ViktorVaczi90/viztisztito_kicad/viztisztito-B_Cu.pdf

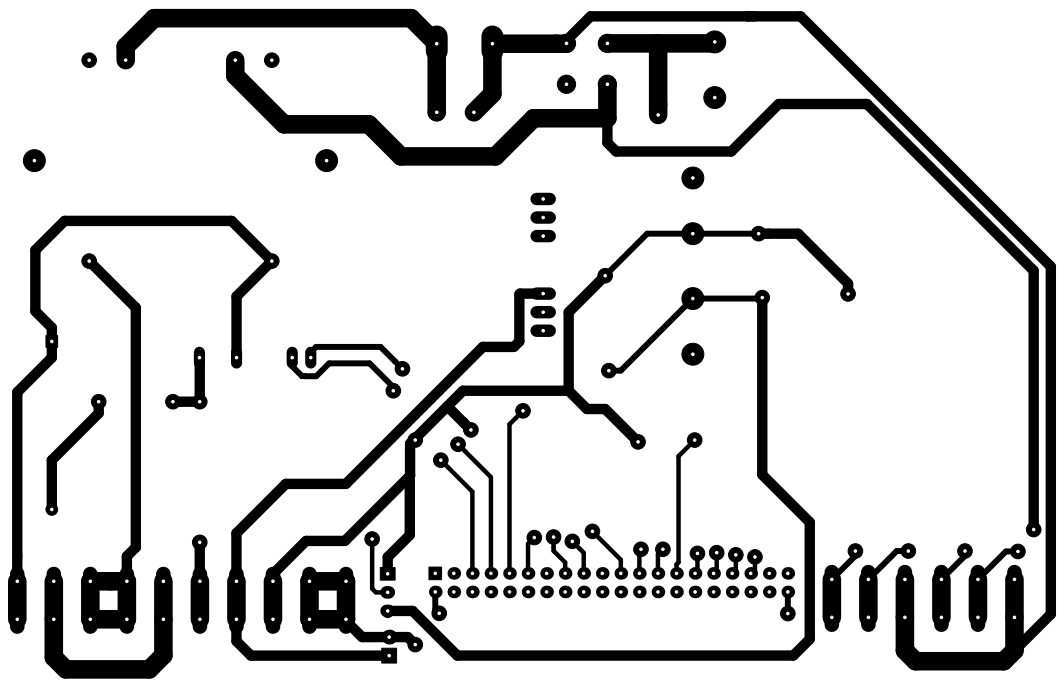
[picture p1: page 1]
