ViktorVaczi90/viztisztito_kicad/viztisztito-F_Cu.pdf

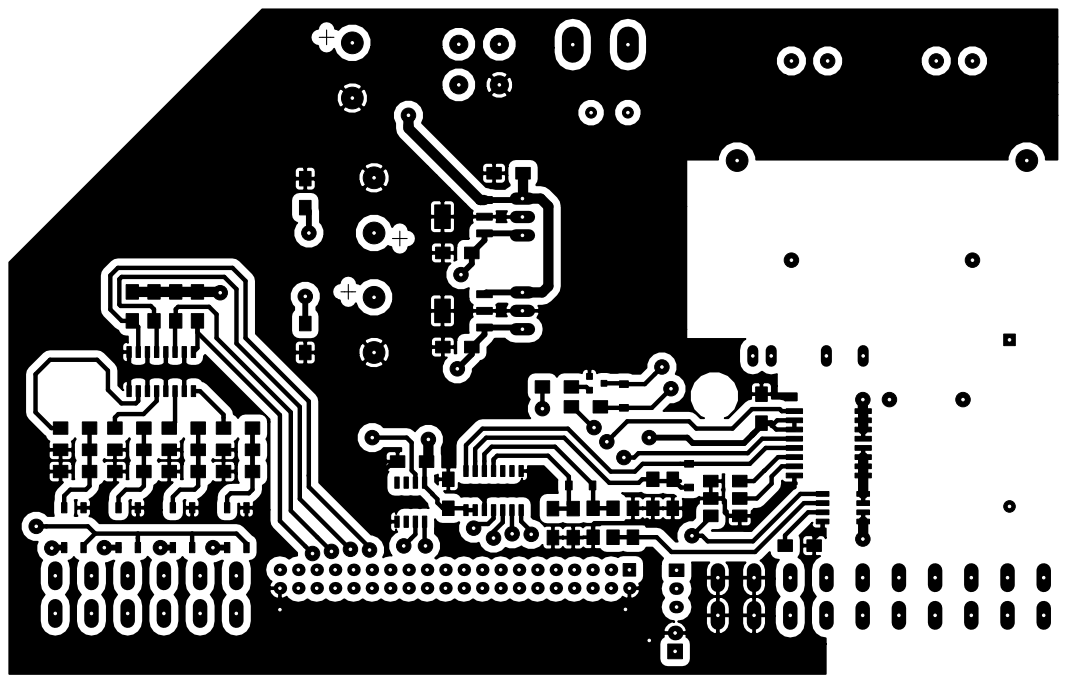
[picture p2: page 1]
