ViktorVaczi90/viztisztito_kicad/viztisztito.kicad_pcb

## KiCad design viztisztito.kicad_pcb (2017-06-14)

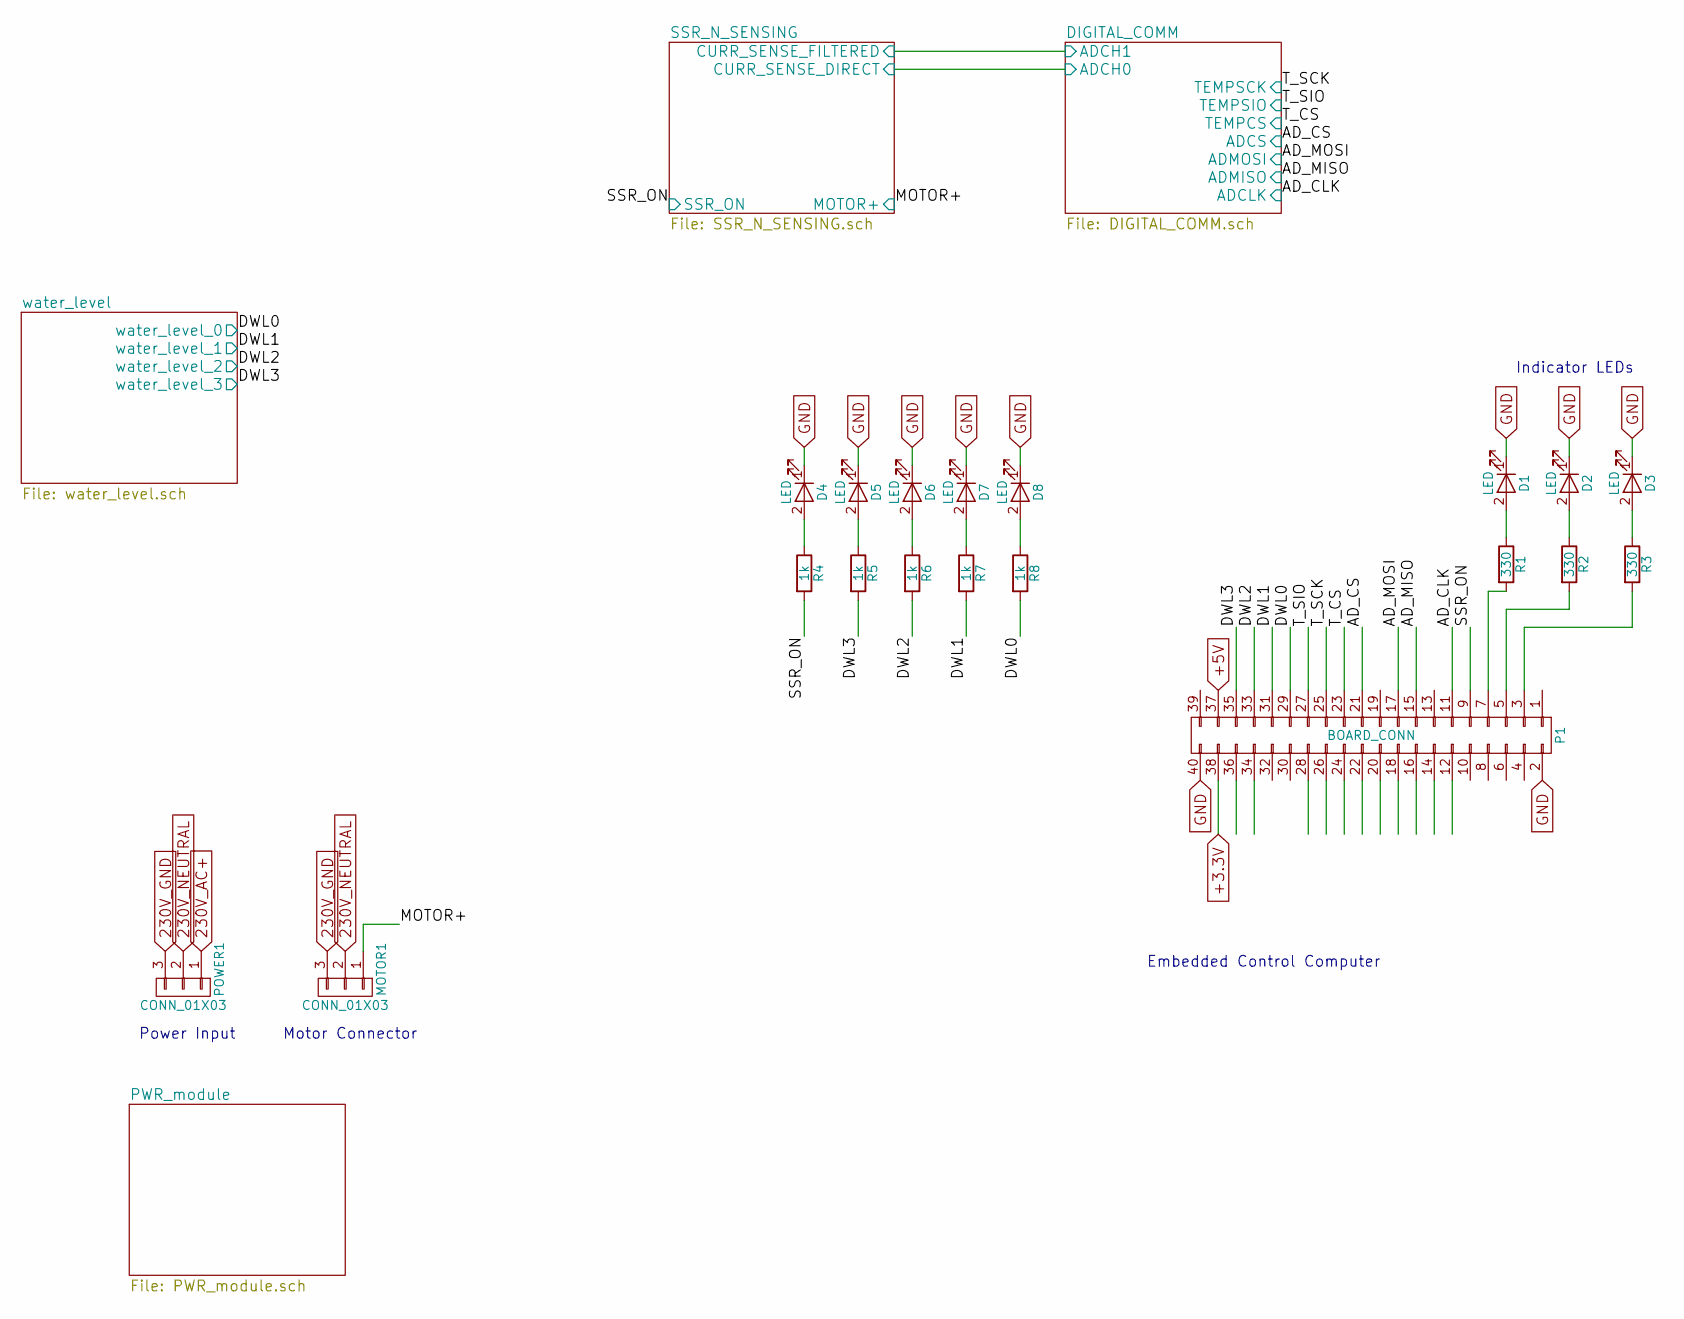
[picture p3: schematic viztisztito.sch]

Parts:
D1, D2, D3, D4, D5, D6, D7, D8: LED; LED_1206
MOTOR1: CONN_01X03; 3x1_TerminalBlock_WAGO-804_RM5mm_3pol
P1: BOARD_CONN; olinuxino_im233_ver2
POWER1: CONN_01X03; 3x1_TerminalBlock_WAGO-804_RM5mm_3pol
R1, R2, R3: 330; R_1206_HandSoldering
R4, R5, R6, R7, R8: 1k; R_1206_HandSoldering

Connections:
230V_AC+: POWER1.1; also elsewhere on the board
230V_GND: MOTOR1.3, POWER1.3
230V_NEUTRAL: MOTOR1.2, POWER1.2; also elsewhere on the board
+3.3V: P1.38; also elsewhere on the board
+5V: P1.37; also elsewhere on the board
/AD_CLK: P1.11; also elsewhere on the board
/AD_CS: P1.21; also elsewhere on the board
/AD_MISO: P1.15; also elsewhere on the board
/AD_MOSI: P1.17; also elsewhere on the board
/DWL0: P1.29, R8.2; also elsewhere on the board
/DWL1: P1.31, R7.2; also elsewhere on the board
/DWL2: P1.33, R6.2; also elsewhere on the board
/DWL3: P1.35, R5.2; also elsewhere on the board
/MOTOR+: MOTOR1.1; also elsewhere on the board
/SSR_ON: P1.9, R4.2; also elsewhere on the board
/T_CS: P1.23; also elsewhere on the board
/T_SCK: P1.25; also elsewhere on the board
/T_SIO: P1.27; also elsewhere on the board
GND: D1.1 (K), D2.1 (K), D3.1 (K), D4.1 (K), D5.1 (K), D6.1 (K), D7.1 (K), D8.1 (K), P1.2, P1.40; also elsewhere on the board
unnamed: D1.2 (A), R1.1
unnamed: D2.2 (A), R2.1
unnamed: D3.2 (A), R3.1
unnamed: D4.2 (A), R4.1
unnamed: D5.2 (A), R5.1
unnamed: D6.2 (A), R6.1
unnamed: D7.2 (A), R7.1
unnamed: D8.2 (A), R8.1
unnamed: P1.3, R3.2
unnamed: P1.5, R2.2
unnamed: P1.7, R1.2

Notes on the sheet:
Power Input
Motor Connector
Embedded Control Computer
Indicator LEDs

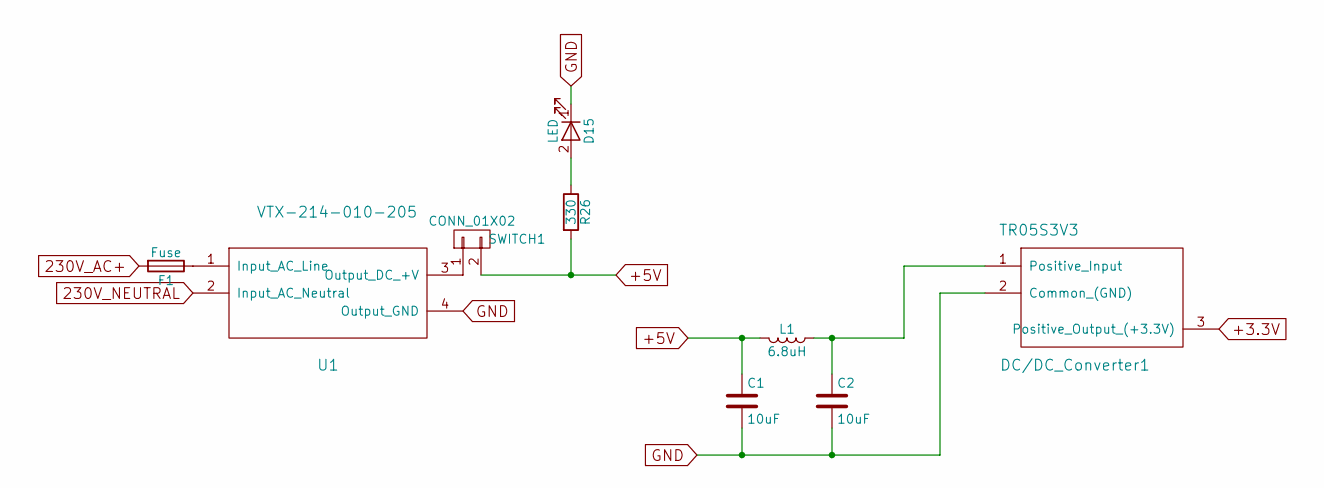
[picture p4: schematic PWR_module.sch]

Parts:
C1, C2: 10uF; C_1210_HandSoldering
D15: LED; LED_1206
DC/DC_Converter1: TR05S3V3
F1: Fuse; FUSE-0031.8201
L1: 6.8uH; SRN3012TA-6R8M
R26: 330; R_1206_HandSoldering
SWITCH1: CONN_01X02; SW1811-1102-01
U1: VTX-214-010-205

Connections:
230V_AC+: F1.2; also elsewhere on the board
230V_NEUTRAL: U1.2 (Input_AC_Neutral); also elsewhere on the board
+3.3V: DC/DC_Converter1.3 (Positive_Output_(+3.3V)); also elsewhere on the board
+5V: C1.1, L1.2, R26.2, SWITCH1.2; also elsewhere on the board
GND: C1.2, C2.2, D15.1 (K), DC/DC_Converter1.2 (Common_(GND)), U1.4 (Output_GND); also elsewhere on the board
unnamed: C2.1, DC/DC_Converter1.1 (Positive_Input), L1.1
unnamed: D15.2 (A), R26.1
unnamed: F1.1, U1.1 (Input_AC_Line)
unnamed: SWITCH1.1, U1.3 (Output_DC_+V)

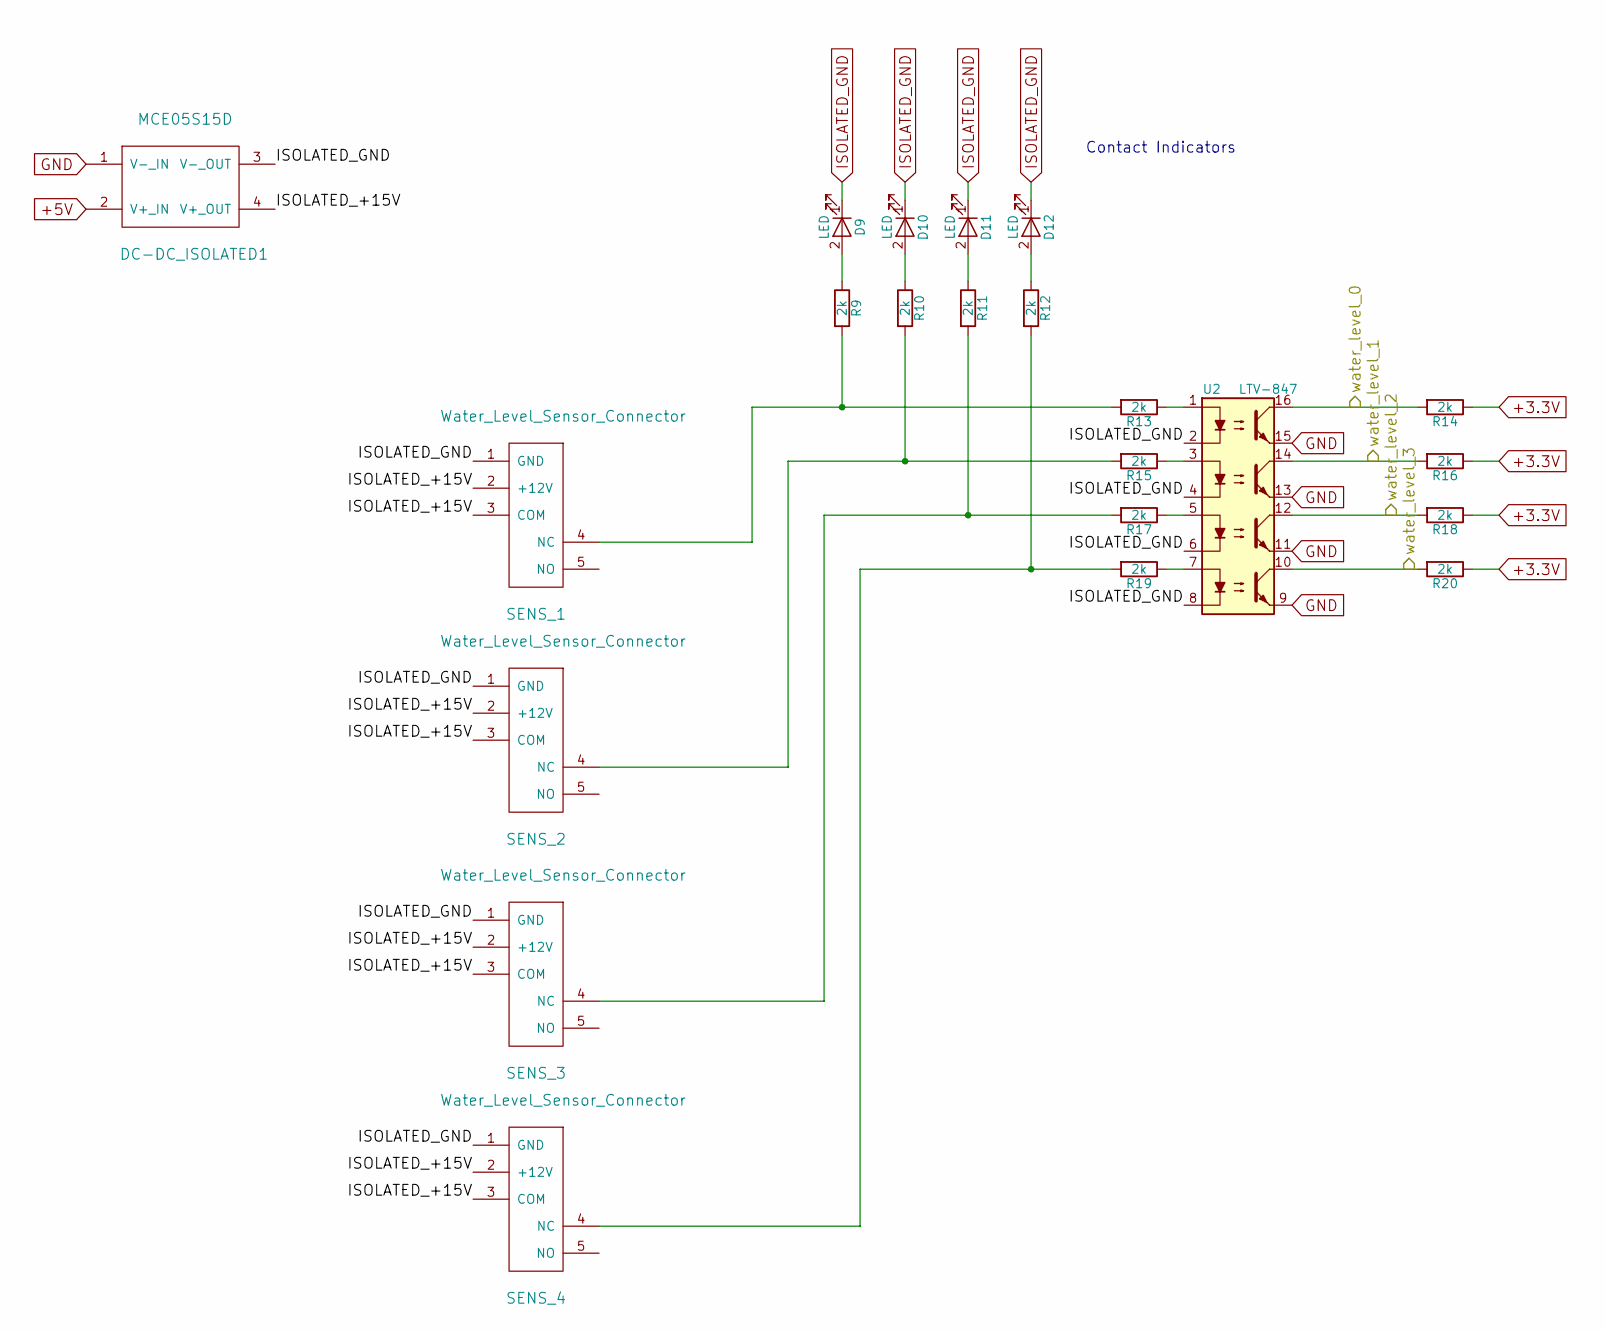
[picture p5: schematic water_level.sch]

Parts:
D9, D10, D11, D12: LED; LED_1206
DC-DC_ISOLATED1: MCE05S15D
R9, R10, R11, R12, R13, R14, R15, R16, R17, R18, R19, R20: 2k; R_1206_HandSoldering
SENS_1, SENS_2, SENS_3, SENS_4: Water_Level_Sensor_Connector; 5x2_TerminalBlock_WAGO-2604-1105
U2: LTV-847; SOIC-16_3.9x9.9mm_Pitch1.27mm

Connections:
+3.3V: R14.1, R16.1, R18.1, R20.1; also elsewhere on the board
+5V: DC-DC_ISOLATED1.2 (V+_IN); also elsewhere on the board
/DWL0: R14.2, U2.16; also elsewhere on the board
/DWL1: R16.2, U2.14; also elsewhere on the board
/DWL2: R18.2, U2.12; also elsewhere on the board
/DWL3: R20.2, U2.10; also elsewhere on the board
/water_level/ISOLATED_+15V: DC-DC_ISOLATED1.4 (V+_OUT), SENS_1.2 (+12V), SENS_1.3 (COM), SENS_2.2 (+12V), SENS_2.3 (COM), SENS_3.2 (+12V), SENS_3.3 (COM), SENS_4.2 (+12V), SENS_4.3 (COM)
GND: DC-DC_ISOLATED1.1 (V-_IN), U2.9, U2.11, U2.13, U2.15; also elsewhere on the board
ISOLATED_GND: D9.1 (K), D10.1 (K), D11.1 (K), D12.1 (K), DC-DC_ISOLATED1.3 (V-_OUT), SENS_1.1 (GND), SENS_2.1 (GND), SENS_3.1 (GND), SENS_4.1 (GND), U2.2, U2.4, U2.6, U2.8
unnamed: D9.2 (A), R9.1
unnamed: D10.2 (A), R10.1
unnamed: D11.2 (A), R11.1
unnamed: D12.2 (A), R12.1
unnamed: R10.2, R15.2, SENS_2.4 (NC)
unnamed: R11.2, R17.2, SENS_3.4 (NC)
unnamed: R12.2, R19.2, SENS_4.4 (NC)
unnamed: R13.1, U2.1
unnamed: R9.2, R13.2, SENS_1.4 (NC)
unnamed: R15.1, U2.3
unnamed: R17.1, U2.5
unnamed: R19.1, U2.7

Notes on the sheet:
Contact Indicators

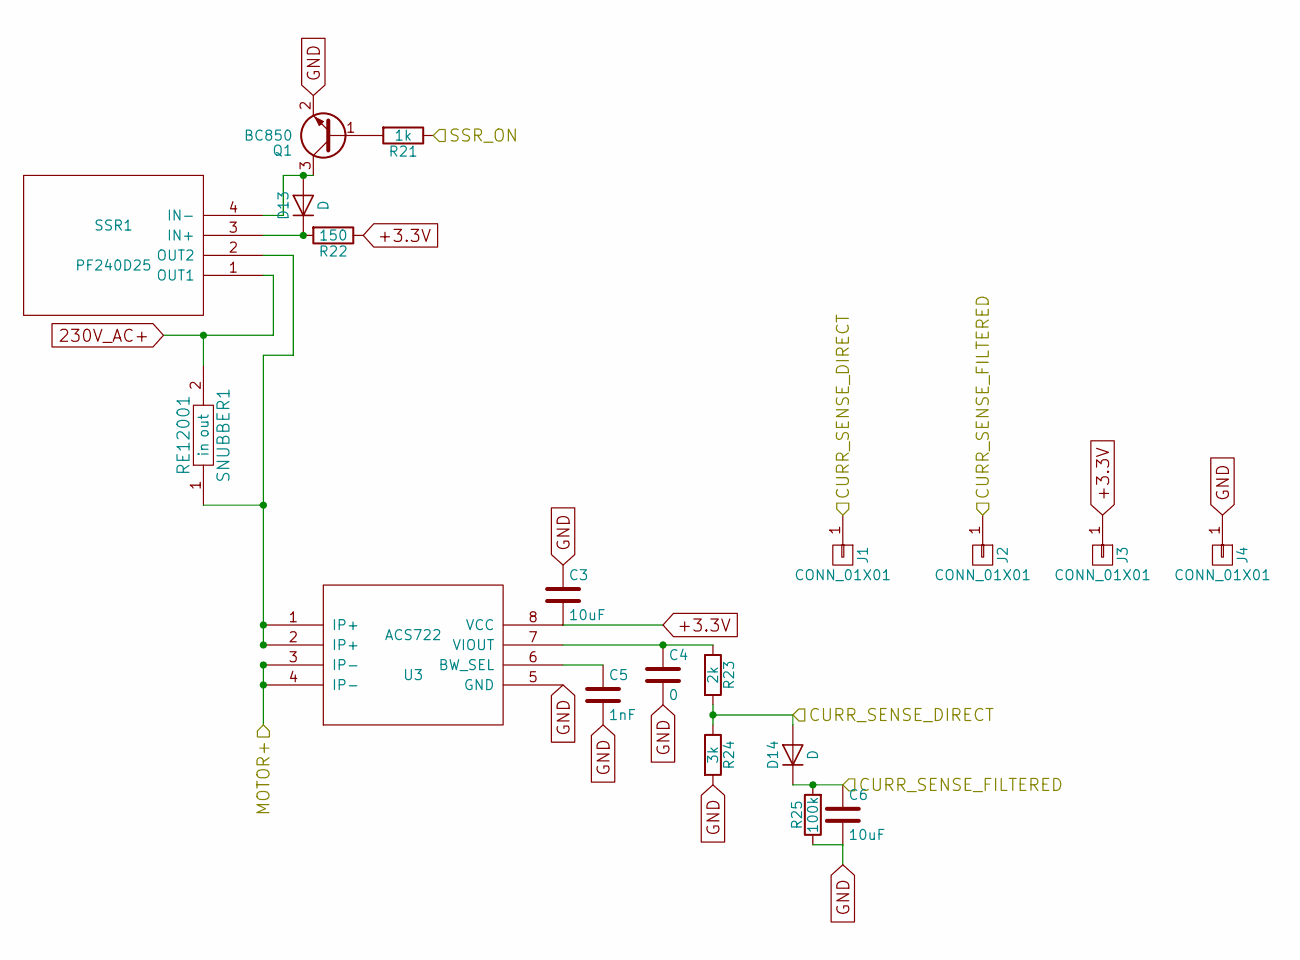
[picture p6: schematic SSR_N_SENSING.sch]

Parts:
C3, C6: 10uF; C_1206_HandSoldering
C4: 0; C_1206_HandSoldering
C5: 1nF; C_1206_HandSoldering
D13, D14: D; D_SOD-123
J1, J2, J3, J4: CONN_01X01; PINTST
Q1: BC850; SOT-23
R21: 1k; R_1206_HandSoldering
R22: 150; R_1206_HandSoldering
R23: 2k; R_1206_HandSoldering
R24: 3k; R_1206_HandSoldering
R25: 100k; R_1206_HandSoldering
SNUBBER1: RE12001
SSR1: PF240D25; s202s02
U3: ACS722; SOIC-8_3.9x4.9mm_Pitch1.27mm

Connections:
230V_AC+: SNUBBER1.2 (out), SSR1.1 (OUT1); also elsewhere on the board
+3.3V: C3.2, J3.1, R22.1, U3.8 (VCC); also elsewhere on the board
/DIGITAL_COMM/ADCH0: D14.2 (A), J1.1, R23.2, R24.1; also elsewhere on the board
/DIGITAL_COMM/ADCH1: C6.1, D14.1 (K), J2.1, R25.2; also elsewhere on the board
/MOTOR+: U3.3 (IP-), U3.4 (IP-); also elsewhere on the board
/SSR_ON: R21.1; also elsewhere on the board
GND: C3.1, C4.2, C5.2, C6.2, J4.1, Q1.2 (E), R24.2, R25.1, U3.5 (GND); also elsewhere on the board
unnamed: C4.1, R23.1, U3.7 (VIOUT)
unnamed: C5.1, U3.6 (BW_SEL)
unnamed: D13.1 (K), R22.2, SSR1.3 (IN+)
unnamed: D13.2 (A), Q1.3 (C), SSR1.4 (IN-)
unnamed: Q1.1 (B), R21.2
unnamed: SNUBBER1.1 (in), SSR1.2 (OUT2), U3.1 (IP+), U3.2 (IP+)

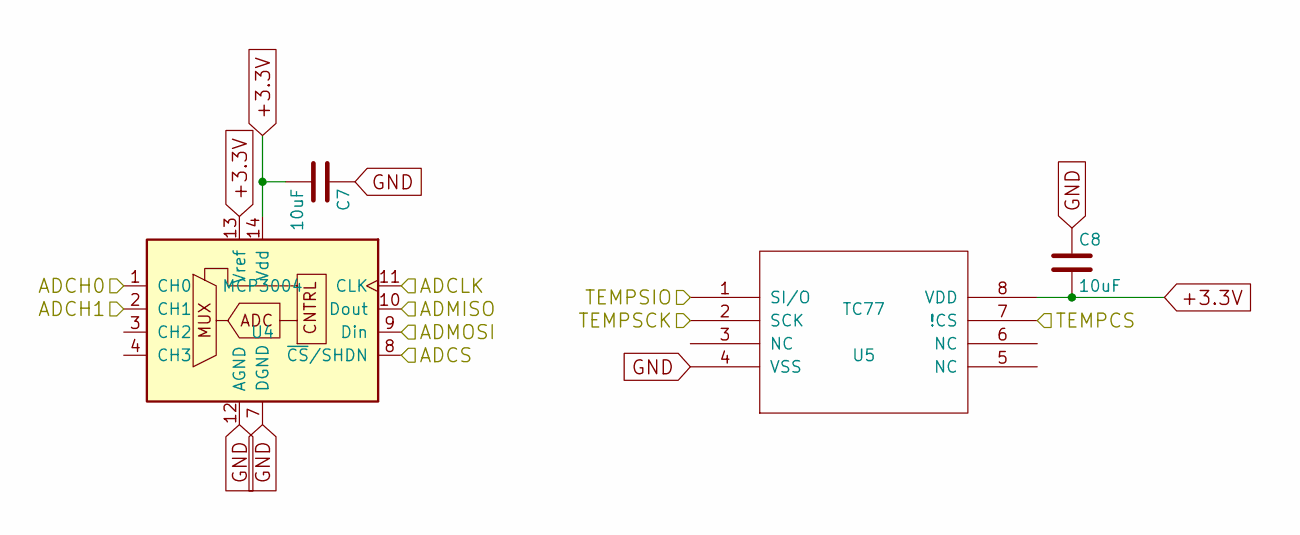
[picture p7: schematic DIGITAL_COMM.sch]

Parts:
C7, C8: 10uF; C_1206_HandSoldering
U4: MCP3004; SOIC-14_3.9x8.7mm_Pitch1.27mm
U5: TC77; SOIC-8_3.9x4.9mm_Pitch1.27mm

Connections:
+3.3V: C7.2, C8.2, U4.13 (Vref), U4.14 (Vdd), U5.8 (VDD); also elsewhere on the board
/AD_CLK: U4.11 (CLK); also elsewhere on the board
/AD_CS: U4.8 (~CS~/SHDN); also elsewhere on the board
/AD_MISO: U4.10 (Dout); also elsewhere on the board
/AD_MOSI: U4.9 (Din); also elsewhere on the board
/DIGITAL_COMM/ADCH0: U4.1 (CH0); also elsewhere on the board
/DIGITAL_COMM/ADCH1: U4.2 (CH1); also elsewhere on the board
/T_CS: U5.7 (!CS); also elsewhere on the board
/T_SCK: U5.2 (SCK); also elsewhere on the board
/T_SIO: U5.1 (SI/O); also elsewhere on the board
GND: C7.1, C8.1, U4.7 (DGND), U4.12 (AGND), U5.4 (VSS); also elsewhere on the board

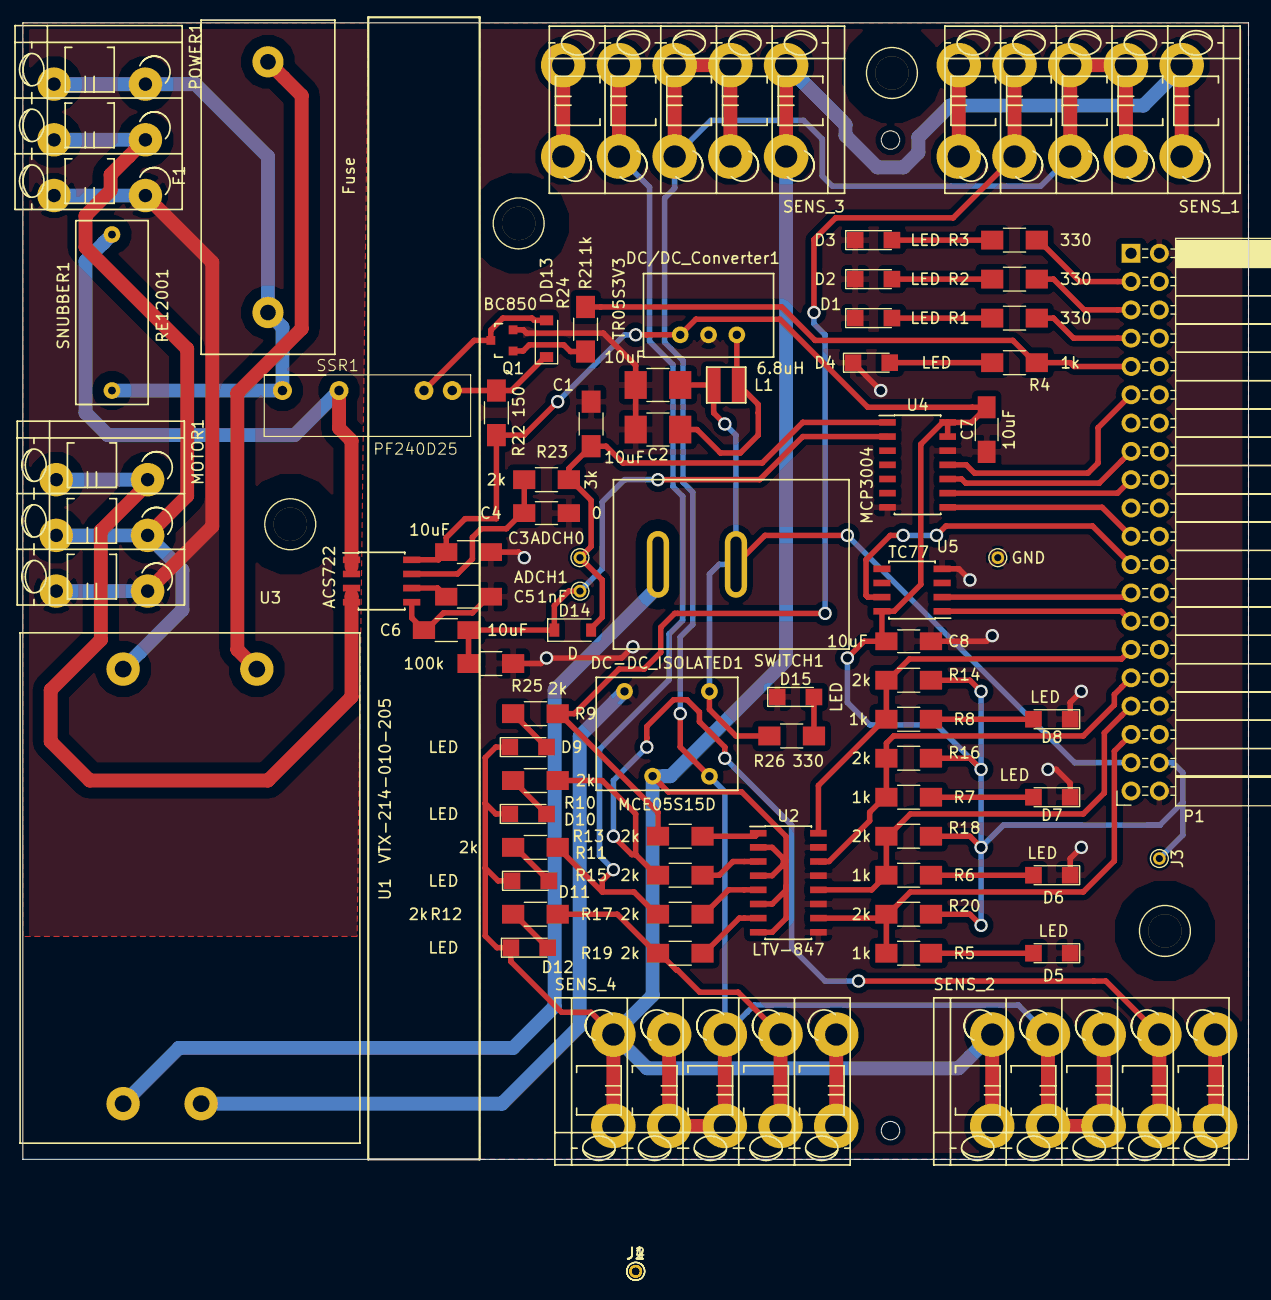
[picture p8: board viztisztito.kicad_pcb from above]

Board: 2 copper layers, 110.0 x 102.0 mm, 76 parts (0 on the bottom side), 56 nets.

Other parts of the board:
ADCH0, ADCH1: CONN_01X01; PINTST
GND: CONN_01X01; PINTST

Their connections:
/DIGITAL_COMM/ADCH0: ADCH0.1; also elsewhere on the board
/DIGITAL_COMM/ADCH1: ADCH1.1; also elsewhere on the board
GND: GND.1; also elsewhere on the board
