ViktorVaczi90/viztisztito_kicad/(commit log)

2015-10-20 sch almost ready
    [DIGITAL_COMM.sch, PWR_module.sch, SSR_N_SENSING.sch, viztisztito.sch, water_level.sch]
2015-10-20 sch ready, begining of layout
    [DIGITAL_COMM.sch, PWR_module.sch, SSR_N_SENSING.sch, viztisztito.kicad_pcb, viztisztito.sch, water_level.sch]
2015-10-20 layout beginning
    [viztisztito.kicad_pcb, viztisztito.sch]
2015-10-22 water level layout
    [viztisztito.kicad_pcb]
2015-10-22 PWR layout
    [PWR_module.sch, SSR_N_SENSING.sch, viztisztito.kicad_pcb]
2015-10-22 almost ready
    [SSR_N_SENSING.sch, viztisztito.kicad_pcb]
2015-10-23 only the main connector left
    [_saved_SSR_N_SENSING.sch, _saved_viztisztito.sch, viztisztito.kicad_pcb]
2015-10-23 little change in routes, not ready
    [viztisztito.kicad_pcb]
2015-10-23 changes in GND routing
    [viztisztito.kicad_pcb]
2015-10-27 maybe final
    [PWR_module.sch, SSR_N_SENSING.sch, _saved_SSR_N_SENSING.sch, _saved_viztisztito.sch, viztisztito.kicad_pcb, viztisztito.sch]
2015-10-28 some minor changes
    [viztisztito.kicad_pcb]
2015-10-29 layout changes
    [viztisztito.kicad_pcb]
2015-10-29 almost final...
    [viztisztito.kicad_pcb, viztisztito.sch]
2015-10-31 printed version
    [PWR_module.sch, SSR_N_SENSING.sch, _saved_SSR_N_SENSING.sch, viztisztito.kicad_pcb]
2016-02-24 new layout, added psu
    [DIGITAL_COMM.sch, PWR_module.sch, SSR_N_SENSING.sch, _saved_PWR_module.sch, viztisztito.kicad_pcb, viztisztito.sch, water_level.sch]
2016-02-24 small change in a cap
    [viztisztito.kicad_pcb]
2016-02-25 change in a track
    [viztisztito.kicad_pcb]
2016-02-26 added edge.cuts
    [viztisztito.kicad_pcb]
2016-02-26 small trace change in power
    [viztisztito.kicad_pcb]
2016-04-09 checked gerbers, possible problems in edge cuts?
    [PWR_module.sch, _saved_PWR_module.sch, _saved_viztisztito.sch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]
2016-05-17 the version sent to Eurocircuits
    [PWR_module.sch, _saved_PWR_module.sch, _saved_viztisztito.sch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]
2017-05-25 - this version has a new power supply 5V 15W - new water level sensing using protectbt
    [DIGITAL_COMM.sch, PWR_module.sch, SSR_N_SENSING.sch, viztisztito.sch, water_level.sch]
2017-05-25 water level simplification
    [water_level.sch]
2017-05-25 fixes after consultation
    [DIGITAL_COMM.sch, SSR_N_SENSING.sch]
2017-05-25 contact fix
    [DIGITAL_COMM.sch]
2017-05-29 - snubber circuit added - diodes selected
    [PWR_module.sch, SSR_N_SENSING.sch, viztisztito.kicad_pcb, viztisztito.sch, water_level.sch]
2017-05-29 all components verified, pcb design required
    [DIGITAL_COMM.sch, PWR_module.sch, SSR_N_SENSING.sch, viztisztito.kicad_pcb, viztisztito.sch, water_level.sch]
2017-05-29 first version of the layout (not wired)
    [SSR_N_SENSING.sch, viztisztito.kicad_pcb]
2017-05-30 backup before rewiring.
    [DIGITAL_COMM.sch, SSR_N_SENSING.sch, viztisztito.kicad_pcb]
2017-05-30 this version has the parts organized; before routing
    [PWR_module.sch, SSR_N_SENSING.sch, viztisztito.kicad_pcb, viztisztito.sch]
2017-05-30 all wired except forgotten and gnd and power
    [viztisztito.kicad_pcb]
2017-05-30 this version has a complete pcb layout
    [viztisztito.kicad_pcb]
2017-05-31 fixed links to the webpage of parts
    [DIGITAL_COMM.sch, PWR_module.sch, SSR_N_SENSING.sch, water_level.sch]
2017-06-01 updated links
    [PWR_module.sch, SSR_N_SENSING.sch, viztisztito.sch, water_level.sch]
2017-06-09 stash commit before the revision of the parts
    [PWR_module.sch, SSR_N_SENSING.sch, viztisztito.kicad_pcb, viztisztito.sch, water_level.sch]
2017-06-10 parts corrected after review; dc/dc converter has to be ordered
    [DIGITAL_COMM.sch, PWR_module.sch, SSR_N_SENSING.sch, viztisztito.sch, water_level.sch]
2017-06-12 before wiring
    [DIGITAL_COMM.sch, PWR_module.sch, SSR_N_SENSING.sch, viztisztito.kicad_pcb, viztisztito.sch, water_level.sch]
2017-06-12 pcb wired
    [viztisztito.kicad_pcb]
2017-06-12 shields corrected; wago connectors connected
    [viztisztito.kicad_pcb, viztisztito.sch, water_level.sch]
2017-06-12 water level connectors
    [viztisztito.kicad_pcb]
2017-06-12 auto verification
    [viztisztito.kicad_pcb]
2017-06-13 before new pcb; - the order of the gpio pins have changed in accordance with olinuxino - indicator leds have been added for debugging - ad current pin added for debugging
    [DIGITAL_COMM.sch, SSR_N_SENSING.sch, viztisztito.kicad_pcb, viztisztito.sch, water_level.sch]
2017-06-14 pcb configuration finished; the next task is the wiring
    [PWR_module.sch, SSR_N_SENSING.sch, viztisztito.kicad_pcb]
2017-06-14 pcb ready; missing: - correct the position of the text - debug information about the leds and the pins
    [viztisztito.kicad_pcb]
2017-06-14 before final verification: - new wiring - control leds - control pins - clearance 10mm - annotations
    [viztisztito.kicad_pcb]
2017-06-14 stash commit
    [viztisztito.kicad_pcb]
